nananek/serial-km-emulator/docs/paper_case_a4.pdf

# SERIAL-KM-EMULATOR / PAPER CASE

A4 landscape, 1:1 net for 0.3 mm cardstock.
Print at 100% / 'Actual size'. Do not use 'fit to page'.
Printed side = inside. Solid = cut, black dashed = valley fold.

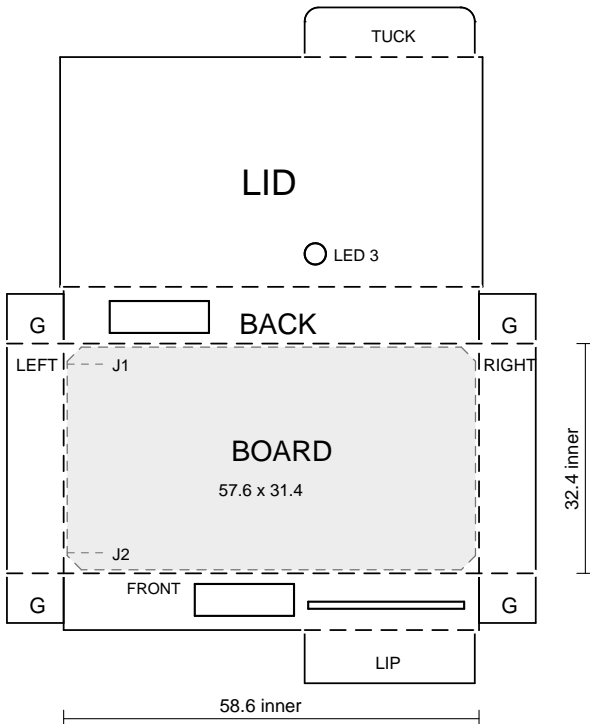
[picture p3: figure]
LED 3; FRONT; LIP; BACK; LID; TUCK; LEFT; RIGHT; BOARD; 58.6 inner; 32.4 inner

8.0

## ASSEMBLY

1. Print on A4 at 100% / 'Actual size' (check the 100 mm bar).
2. Printed side = inside. Solid = cut, black dashed = valley fold.
3. Cut the two USB-C openings, the 3 mm LED hole and the 22 x 1 mm tuck slot in the front wall.
4. Fold up the walls and fold the inner lip (LIP) down inside the front wall. Glue the tabs (G) to the front and back walls.
5. Fold the lid over and push the 24 mm tongue (7 mm deep) through the slot. The lip behind the slot catches it.
6. To open, lift the front edge of the lid; the tongue slides out.
7. Put the board on the floor with J1 (serial) at the BACK wall
and J2 (HID) at the FRONT wall. The mouths pass through the two openings, and the LED sits under the 3 mm hole.
8. No screws. Use tape or a foam pad if the board rattles.
9. Chamfer the USB-C openings outside if a plug overmould catches.

### DIMENSIONS (mm)

inner | 58.6 x 32.4 x 8.0
board | 57.6 x 31.4 x 1.6
wall | 0.3 cardstock (recommended)
USB-C open 14.0 x 4.5, 1.5 above floor,
one in the front and one in the back wall LED hole 3.0 dia, 35.5 / 4.7 from hinge
glue tab 7 mm, four corners
tuck tongue 24 x 7.0 mm, rounded tip
tuck slot 22 x 1.0, 3.5 below rim
inner lip 24 x 7.5, behind the slot

### LINE TYPES

cut
fold (valley)
grey dashed = board outline (reference)

The QR code on the board back is hidden while the board is in the box. Take the board out to scan it.

0 | 50 | 100

100 mm scale check (mm)

Generated by scripts/gen_paper_box.py from serial-km-emulator.kicad_pcb
