nananek/serial-km-emulator/docs/pcb_routing.png

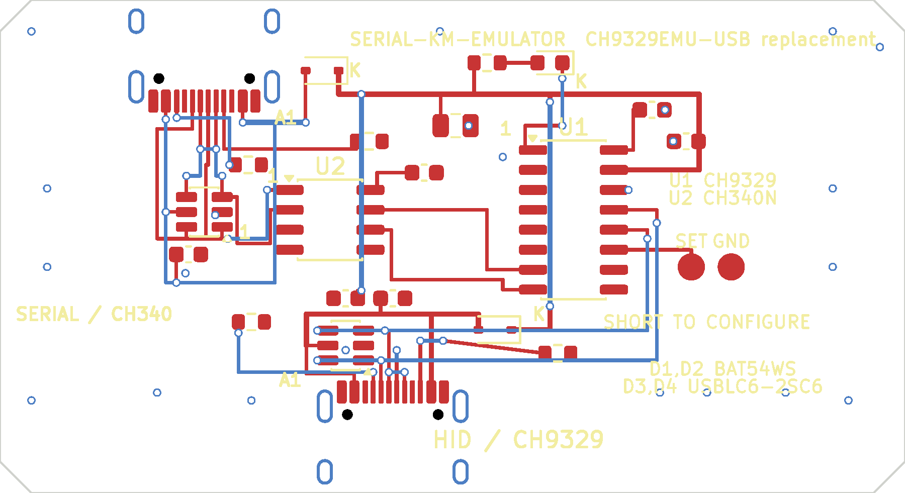
docs/pcb_routing.png
