nananek/serial-km-emulator/(commit log)

2026-11-01 Add a printable paper case net
2026-11-01 Make the paper case lid reopenable
    The lid tucked 6 mm into the front wall with no grip, so once closed it
    could not be opened again without tearing the paper. Cut a 16 x 5 mm
    thumb notch in the front wall, which is deeper than the flap and exposes
    its bottom edge, and reduce the tuck to 4 mm with a taper from 43 to
    37 mm and rounded tip corners so it slides out. Keep the notch deeper
    than the tuck and stop the build if that is ever broken. Update the
    assembly notes, dimensions and README, and regenerate the A4 net.
2026-11-01 Put the paper case tuck through a front slot
    The lid tuck only lay against the outside of the front wall; the thumb
    notch from the previous change did not give it a hole to enter. Cut a
    37 x 1 mm slot in the front wall 3.5 mm below the rim and add a
    43 x 7.5 mm inner lip below the front wall. The lip folds down inside
    and catches the tuck after it passes through the slot.
    Make the tuck a constant-width 38 x 7 mm tongue with a rounded tip.
    A tapered flap cannot be pulled back through a slot narrower than its
    fold, so the taper is gone; the slot is 1 mm narrower than the tongue
    for a light grip. Keep the tongue and lip inside the front glue tabs.
    Update the assembly notes, dimensions and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
2026-11-01 Use standard 0.5/0.3 mm vias for the USB data escape
    JLCPCB treats a 0.15 mm drill as an advanced process. The ten 0.15 mm
    vias in the Type-C escape added the minimum-via option, plugged via
    covering, and the 4-wire Kelvin test to the quote: 10,503 yen on top of
    a 629 yen five-piece PCB.
    Use the board's existing 0.5/0.3 mm vias instead. The only place where
    the larger pad did not fit was the USB_SER_DM via at (10.5, 14.45),
    which was 0.099 mm from R2 pad 2; move it to (10.6, 14.45) to restore
    clearance. Refill the GND zones and regenerate the fabrication outputs.
    DRC: 0 violations, 0 unconnected. ERC: 0 violations. The PTH drill
    file now contains only 0.3 mm and 0.6 mm holes.
    [serial-km-emulator-B_Cu.gbl, serial-km-emulator-B_Mask.gbs, serial-km-emulator-B_Paste.gbp, serial-km-emulator-B_Silkscreen.gbo, serial-km-emulator-Edge_Cuts.gm1, serial-km-emulator-F_Cu.gtl, serial-km-emulator-F_Mask.gts, serial-km-emulator-F_Paste.gtp]
2026-11-09 Put the Type-C ports on opposite long edges
    Move J1 to the top edge and J2 to the bottom edge so the two plugs leave
    in opposite directions and no longer foul each other. Cut the top-right
    corner as well, so all four corners are 2 mm punch cuts.
    Rework the serial, HID, CC and VBUS fan-outs for the new positions and
    refresh the schematic note, fabrication files and board images.
    Rebuild the paper case for one opening in each long wall and move the
    tuck mechanism to the right of the front-wall USB-C opening.
    DRC and ERC are clean.
    [pos_kicad.csv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]
